javeharron/clearmindprotocol/README.md

# clearmindprotocol
The ClearMind Protocol is a communications framework for non-invasive brain to brain interface systems, specifically using the 10-20 International System as a basis. This repository exists to detail the prototype ultrasound transducer for non-invasive neurostimulation.

DISCLAIMER: This device is a prototype system. Please do not use on a human subject.

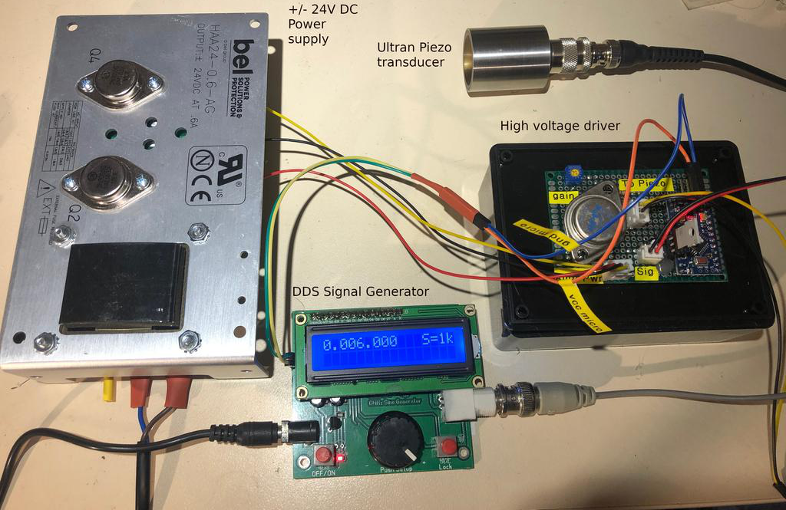
[picture p1: design/wiringSetup/wiring_setup.jpeg]
Setup
