javeharron/clearmindprotocol/circuit/PiezoDriverSchematic.pdf

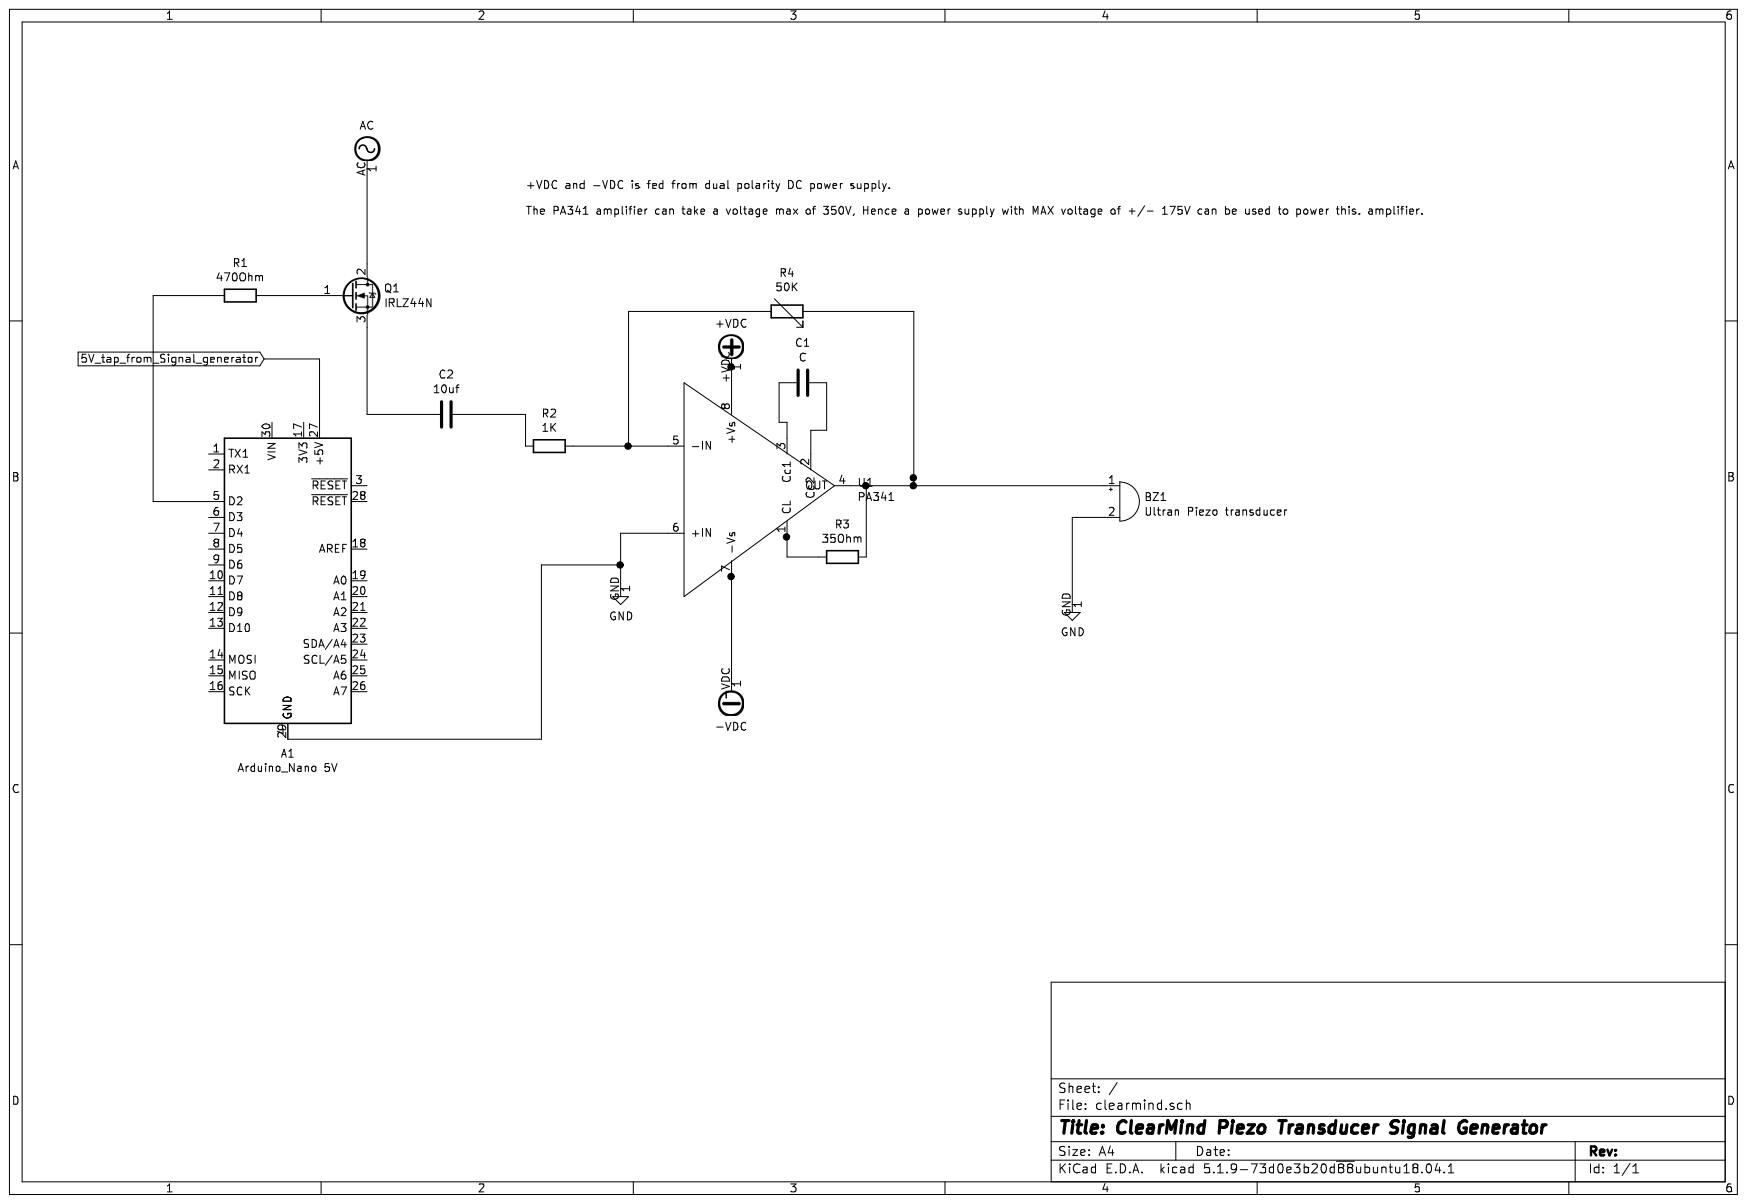
[picture p5: page 1]
