javeharron/clearmindprotocol/signalCapture/DS1Z_QuickPrint3.png

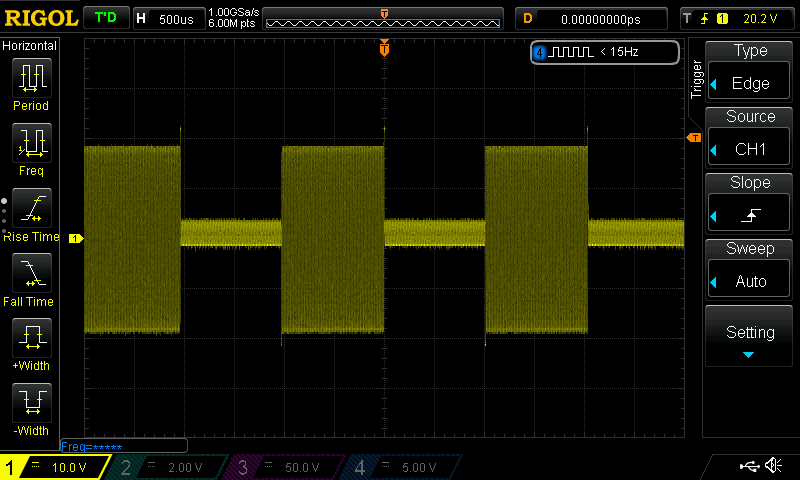
signalCapture/DS1Z_QuickPrint3.png
