javeharron/clearmindprotocol/signalCapture/DS1Z_QuickPrint4.png

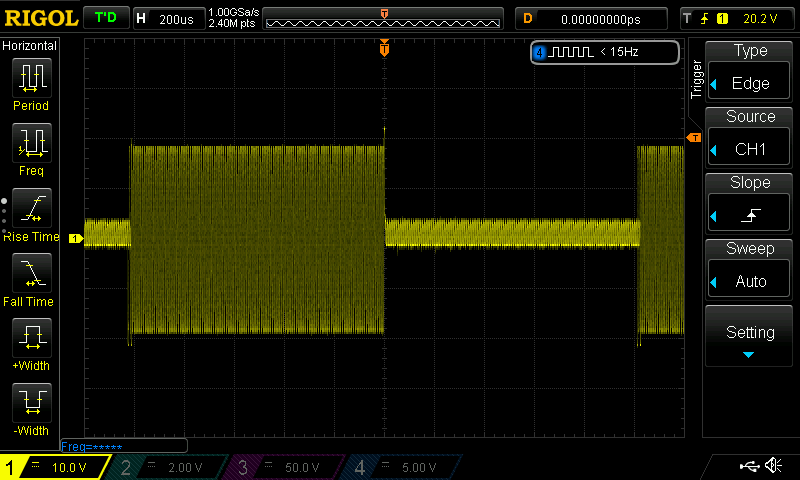
signalCapture/DS1Z_QuickPrint4.png
