javeharron/clearmindprotocol/signalCapture/DS1Z_QuickPrint6.png

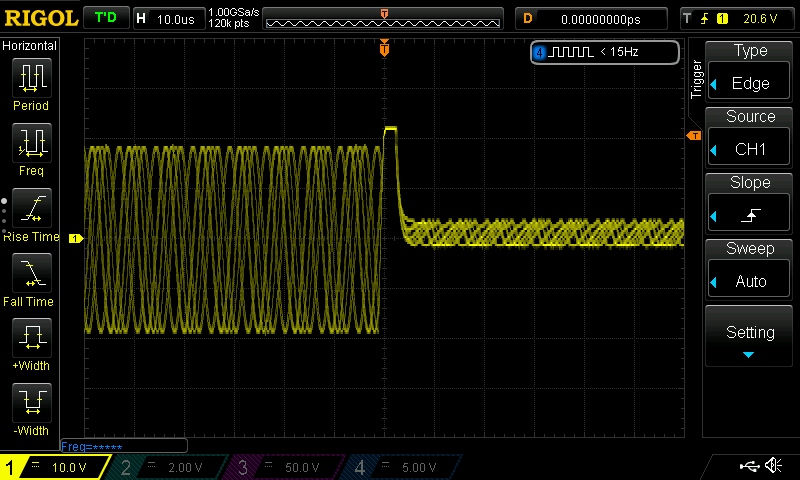
signalCapture/DS1Z_QuickPrint6.png
