javeharron/clearmindprotocol/(commit log)

2021-01-20 Initial commit: Add schematic and microcontroller code
2021-02-04 Add signal captures of the Driver
2021-03-31 Add wiring image
